Resaj/mando_rc/images/IMG-20140307-WA0002.jpg

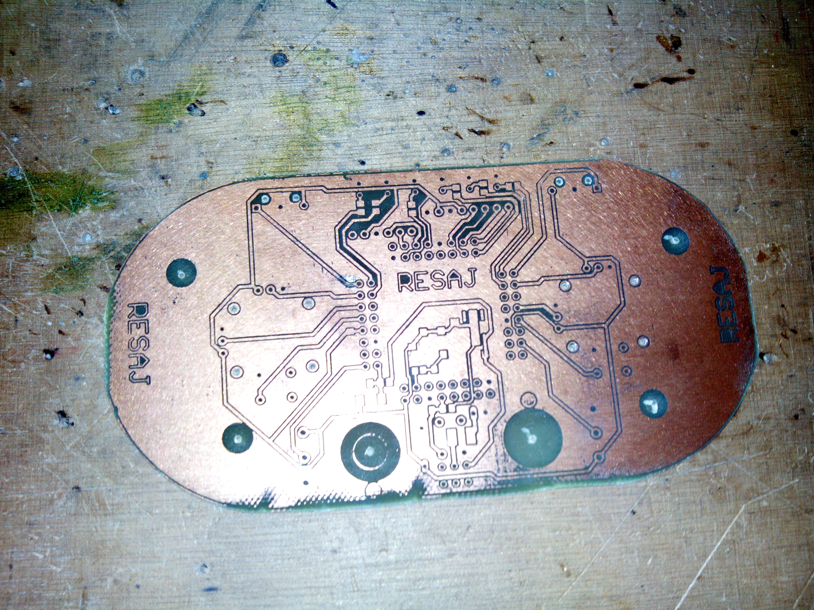
images/IMG-20140307-WA0002.jpg
