Resaj/mando_rc/images/IMG-20140309-WA0013.jpg

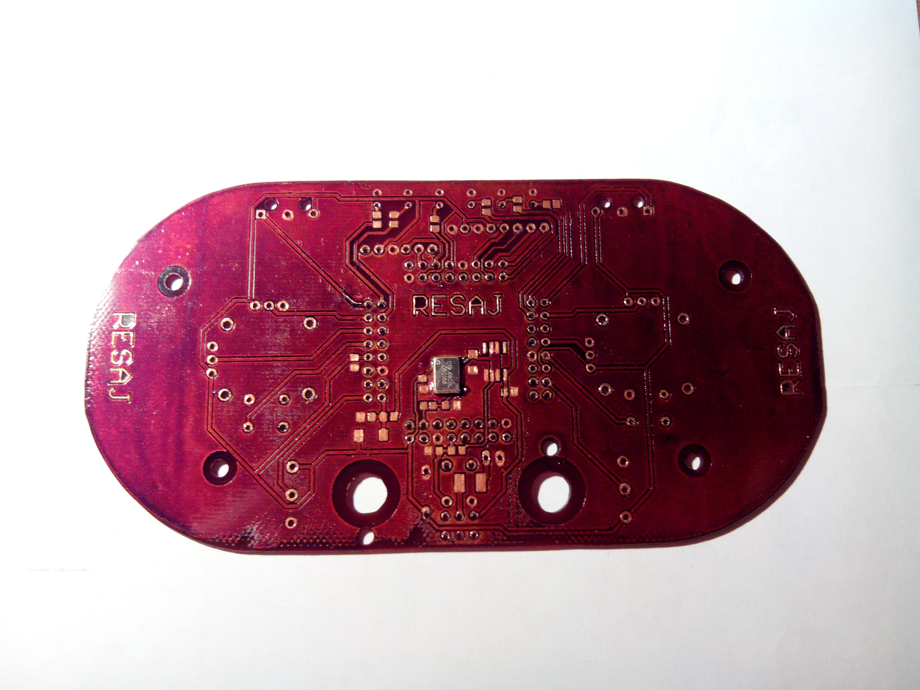
images/IMG-20140309-WA0013.jpg
