Resaj/mando_rc/images/IMG-20140312-WA0003.jpg

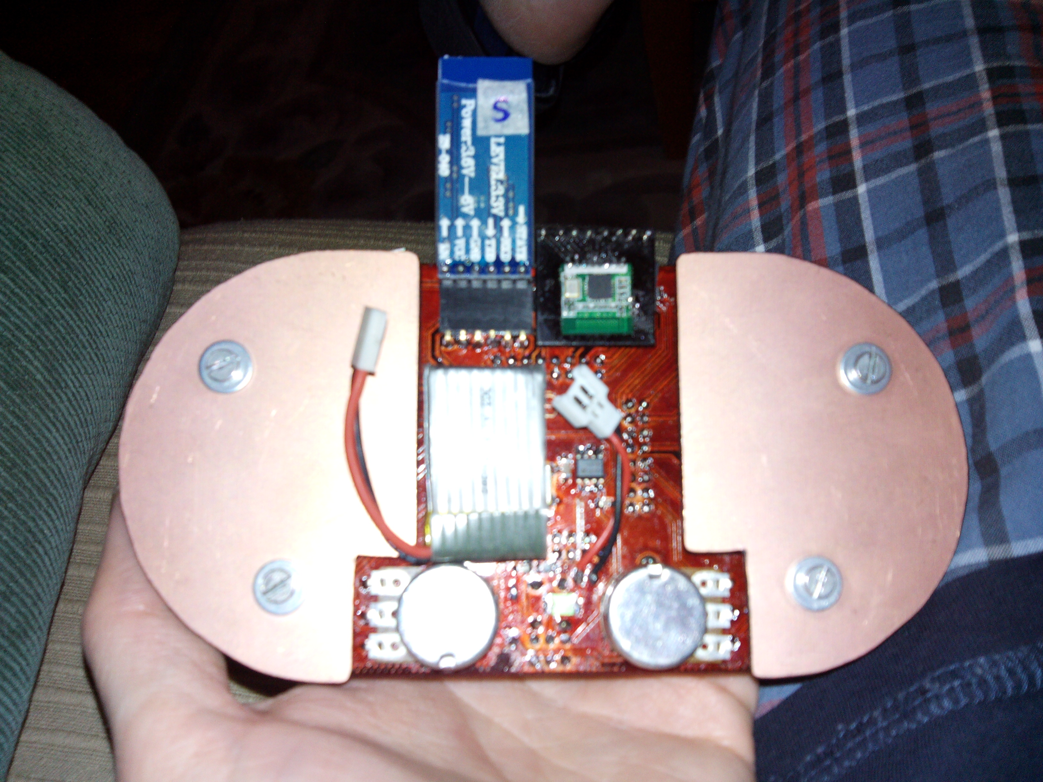
images/IMG-20140312-WA0003.jpg
