Resaj/mando_rc/images/IMG-20140319-WA0000.jpg

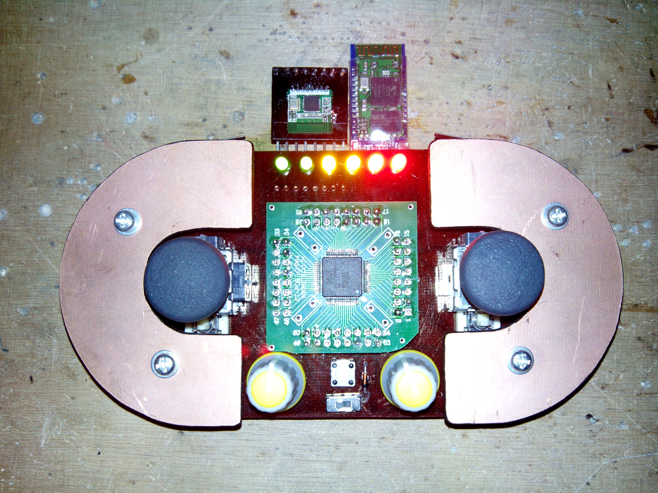
images/IMG-20140319-WA0000.jpg
