Resaj/mando_rc/images/IMG_20161116_005844.jpg

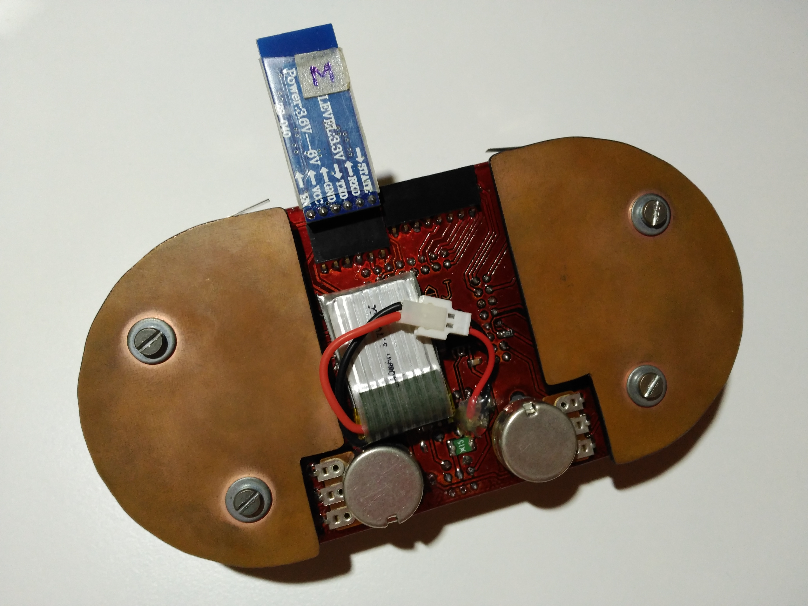
images/IMG_20161116_005844.jpg
