Resaj/mando_rc/eagle/Mando/Fotolitos/Adaptador RF2400nano.pdf

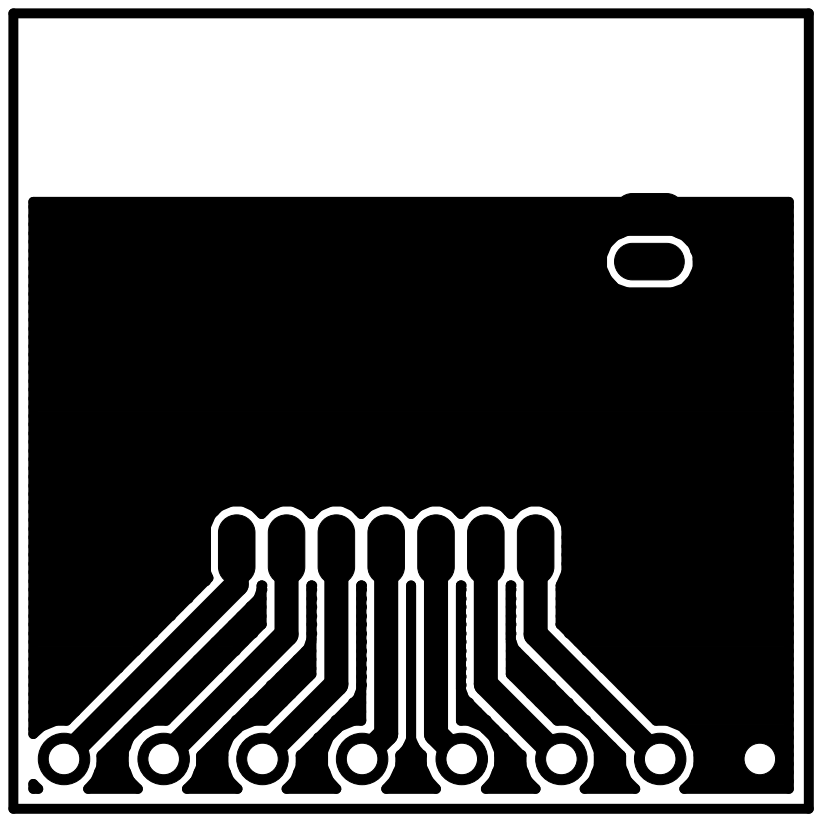
[picture p7: page 1]
