Resaj/mando_rc/eagle/Mando/Fotolitos/Mando.pdf

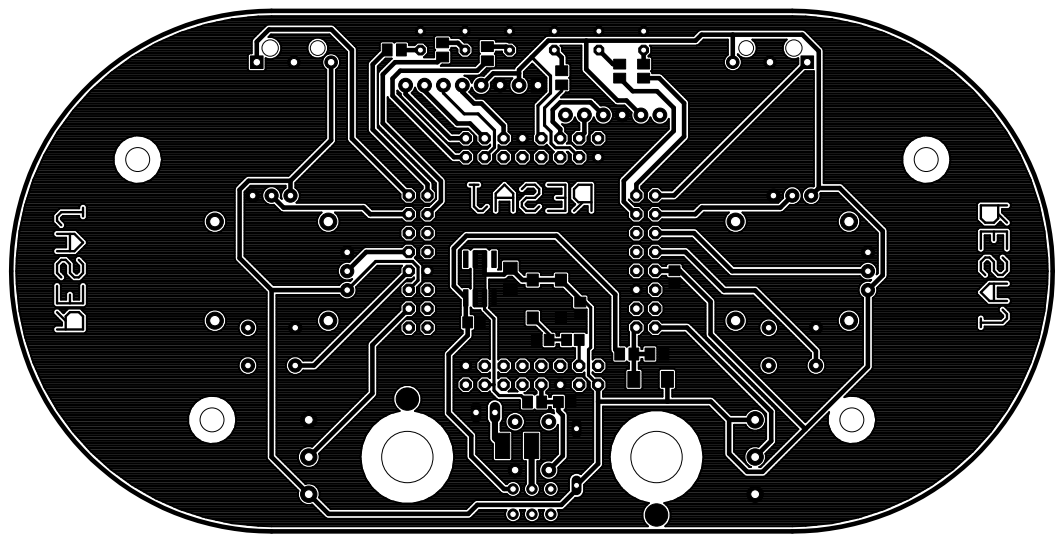
[picture p8: page 1]
