Resaj/mando_rc/eagle/Mando/Mando.brd

## EAGLE design eagle/Mando/Mando.brd (2016-11-15)

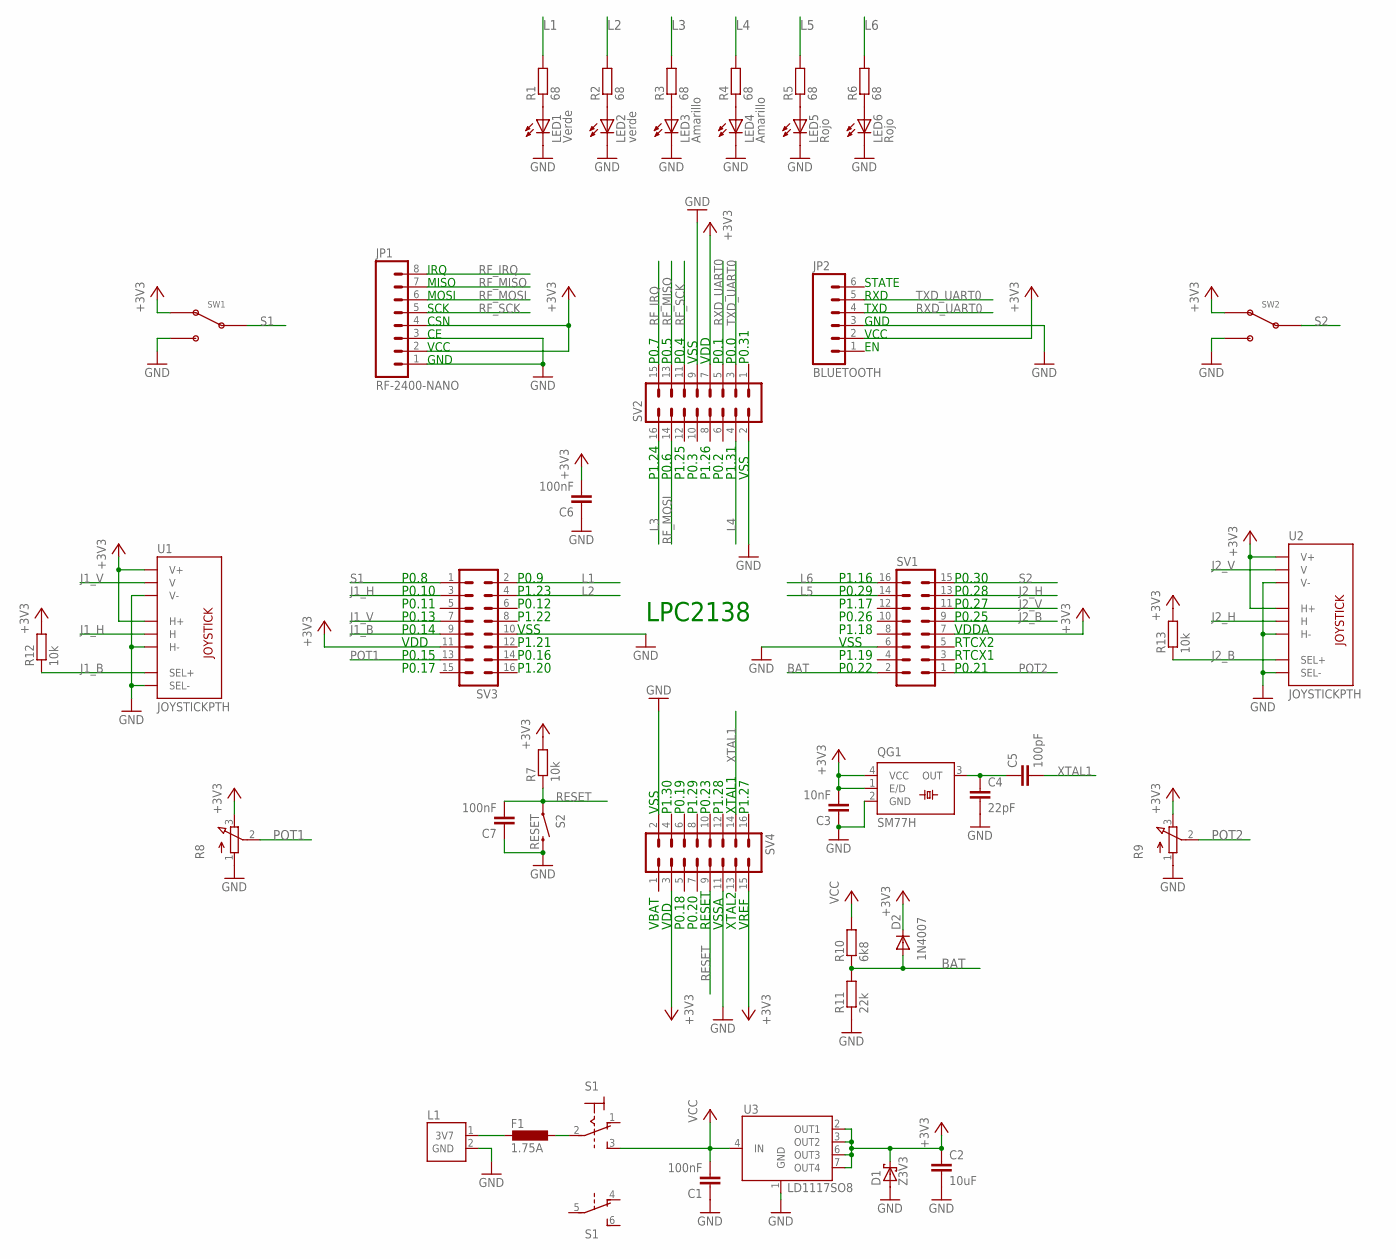
[picture p9: schematic Mando.sch]

Parts:
C1, C6, C7: 100nF; C0805
C2: 10uF; C1206
C3: 10nF; C0805
C4: 22pF; C0805
C5: 100pF; C0805
D1: Z3V3; DO35-7
D2: 1N4007; SOD106-R
F1: 1.75A; L1812
JP1: RF-2400-NANO; 1X08
JP2: BLUETOOTH; 1X06
L1: CONECTOR_LIPO_3.7V
LED1: Verde; LED3MM
LED2: verde; LED3MM
LED3, LED4: Amarillo; LED3MM
LED5, LED6: Rojo; LED3MM
QG1: SM77H
R1, R2, R3, R4, R5, R6: 68; M0805
R7, R12, R13: 10k; M0805
R8, R9: 3RP/1610N
R10: 6k8; M0805
R11: 22k; M0805
S1: SWITCH_2P2T_SL; SLIDE_SWITCH_2P2T
S2: RESET; TACTILE-PTH
SV1, SV2, SV3, SV4: MA08-2
SW1, SW2: SW_1382_R/A; SW_MX1382
U1, U2: JOYSTICKPTH; JOYSTICK
U3: LD1117SO8; SO8

Connections:
+3V3: C2.1, C3.2, C6.2, D1.C, D2.C, JP1.2, JP1.4, JP2.2, QG1.1 (E/D), QG1.4 (VCC), R7.2, R8.3 (E), R9.3 (E), R12.2, R13.2, SV1.7, SV2.7, SV3.11, SV4.3, SV4.15, SW1.N.C, SW2.N.C, U1.H1 (H+), U1.V1 (V+), U2.H1 (H+), U2.V1 (V+), U3.2 (OUT1), U3.3 (OUT2), U3.6 (OUT3), U3.7 (OUT4)
BAT: D2.A, R10.1, R11.2, SV1.2
GND: C1.1, C2.2, C3.1, C4.2, C6.1, C7.1, D1.A, JP1.1, JP1.3, JP2.3, L1.2 (GND), LED1.K (C), LED2.K (C), LED3.K (C), LED4.K (C), LED5.K (C), LED6.K (C), QG1.2 (GND), R8.1 (A), R9.1 (A), R11.1, S2.3 (2), SV1.6, SV2.2, SV2.9, SV3.10, SV4.2, SV4.11, SW1.N.O, SW2.N.O, U1.B2A (SEL-), U1.H3 (H-), U1.V3 (V-), U2.B2A (SEL-), U2.H3 (H-), U2.V3 (V-), U3.1 (GND)
J1_B: R12.1, SV3.9, U1.B1A (SEL+)
J1_H: SV3.3, U1.H2 (H)
J1_V: SV3.7, U1.V2 (V)
J2_B: R13.1, SV1.9, U2.B1A (SEL+)
J2_H: SV1.13, U2.H2 (H)
J2_V: SV1.11, U2.V2 (V)
L1: R1.2, SV3.2
L2: R2.2, SV3.4
L3: R3.2, SV2.16
L4: R4.2, SV2.4
L5: R5.2, SV1.14
L6: R6.2, SV1.16
unnamed: F1.2, L1.1 (3V7)
unnamed: F1.1, S1.2
unnamed: LED1.A, R1.1
unnamed: C4.1, C5.1, QG1.3 (OUT)
unnamed: LED2.A, R2.1
unnamed: LED3.A, R3.1
unnamed: LED4.A, R4.1
unnamed: LED5.A, R5.1
unnamed: LED6.A, R6.1
POT1: R8.2 (S), SV3.13
POT2: R9.2 (S), SV1.1
RESET: C7.2, R7.1, S2.1, SV4.9
RF_IRQ: JP1.8, SV2.15
RF_MISO: JP1.7, SV2.13
RF_MOSI: JP1.6, SV2.14
RF_SCK: JP1.5, SV2.11
RXD_UART0: JP2.4, SV2.5
S1: SV3.1, SW1.COM
S2: SV1.15, SW2.COM
TXD_UART0: JP2.5, SV2.3
VCC: C1.2, R10.2, S1.3 (S), U3.4 (IN)
XTAL1: C5.2, SV4.14

Notes on the sheet:
LPC2138
P0.21
P0.22
P0.25
P0.26
P0.27
P0.28
P0.29
P0.30
P0.31
P0.0
P1.31
P0.1
P0.2
P1.26
P0.3
P0.4
P0.5
P0.6
P0.7
P1.24
VBAT
VSS
VDD
P1.30
P0.18
P0.19
P0.20
P1.29
RESET
P0.23
VSSA
P1.28
XTAL2
XTAL1
VREF
P1.27
P1.20
P0.17
P0.8
P0.9
P0.10
P1.23
P0.11
P0.12
P0.13
P1.22
P0.14
P1.21
P0.15
P0.16
P1.25
RTCX1
RTCX2
VDDA
P1.18
P1.19
P1.17
P1.16
IRQ
MISO
MOSI
SCK
CSN
VCC
GND
STATE
RXD
TXD

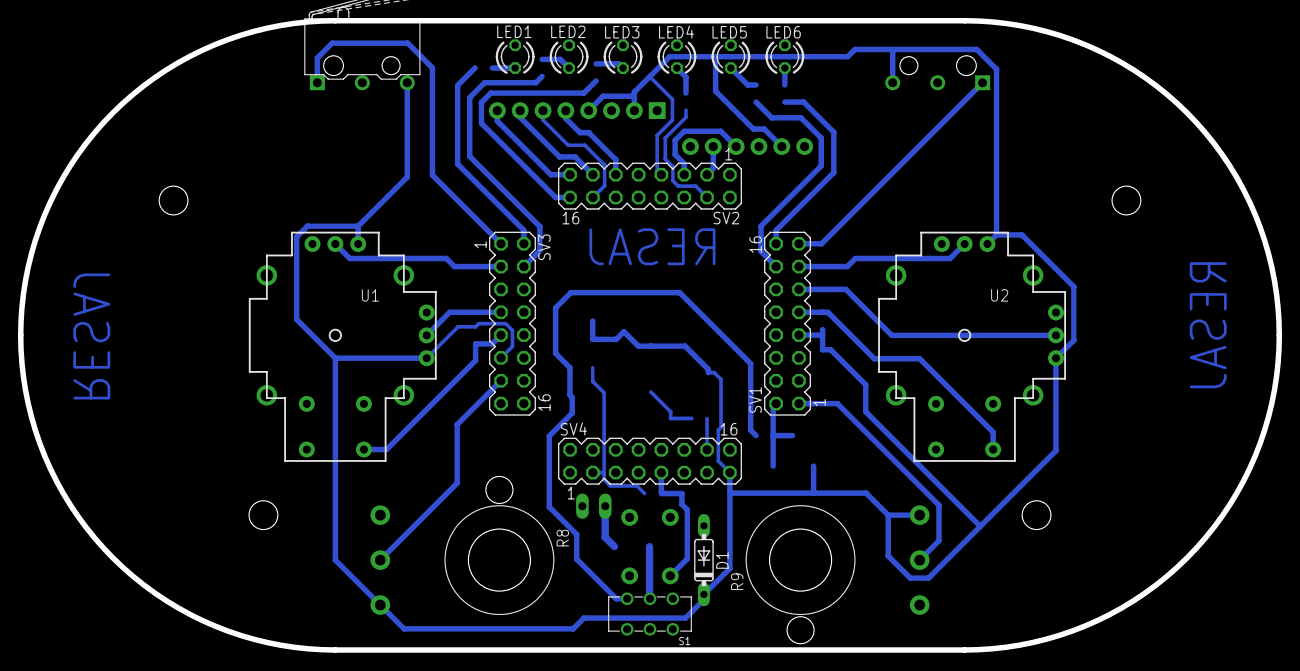
[picture p10: board Mando.brd from above]

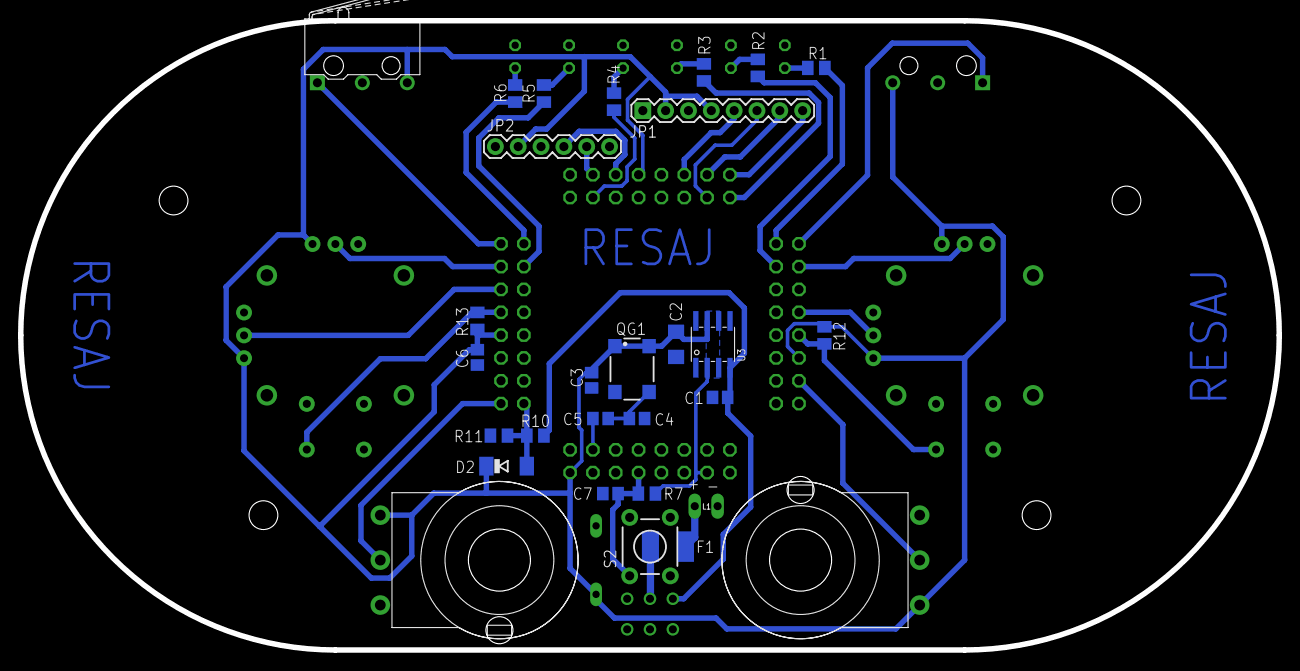
[picture p11: board Mando.brd from below]

Board: 2 copper layers, 140.0 x 70.0 mm, 44 parts (27 on the bottom side), 37 nets.
