Resaj/mando_rc/Programa mando sumo Cybertech 2012/LPClib.c

#ifndef LPCLIB_C
#define LPCLIB_C

#include <lpc213x.h>
#include "LPClib.h"
#include "target.h"


// Variables auxiliares para decodificar la señal del mando
unsigned long dato_mando = 0;			// Valor decodificado de la señal enviada por el mando
unsigned long captura_1, captura_2;		// Variables para tomar el número de cuentas en Capture0.0
int n_bit = 0;							// Variables auxiliares para tomar la señal del mando
char bit_start = '0', inicio_dato = '0';

// Variables auxiliares para el control de la UART0
char *uart0_buf_tx[N_MSG_UART0];
char uart0_rd = 0, uart0_wr = 0, uart0_repose = '1';
char uart0_msg = '0';
char uart0_cero = 0;
char *uart0_ptr_tx = &uart0_cero;


void ADC_CH_config(struct analog data_adc)
{
	struct data data_pin;
	data_pin.port = 0;

	if(data_adc.adc == ADC_0)
	{
		switch(data_adc.channel)
		{
			case ADC_CH0:
				data_pin.pin = 27;
				PINSEL_config(data_pin, ADC);
				break;
			case ADC_CH1:
				data_pin.pin = 28;
				PINSEL_config(data_pin, ADC);
				break;
			case ADC_CH2:
				data_pin.pin = 29;
				PINSEL_config(data_pin, ADC);
				break;
			case ADC_CH3:
				data_pin.pin = 30;
				PINSEL_config(data_pin, ADC);
				break;
			case ADC_CH4:
				data_pin.pin = 25;
				PINSEL_config(data_pin, ADC);
				break;
			case ADC_CH5:
				data_pin.pin = 26;
				PINSEL_config(data_pin, ADC);
				break;
			case ADC_CH6:
				data_pin.pin = 4;
				PINSEL_config(data_pin, ADC);
				break;
			case ADC_CH7:
				data_pin.pin = 5;
				PINSEL_config(data_pin, ADC);
		}
	}
	else if(data_adc.adc == ADC_1)
	{
		switch(data_adc.channel)
		{
			case ADC_CH0:
				data_pin.pin = 6;
				PINSEL_config(data_pin, ADC);
				break;
			case ADC_CH1:
				data_pin.pin = 8;
				PINSEL_config(data_pin, ADC);
				break;
			case ADC_CH2:
				data_pin.pin = 10;
				PINSEL_config(data_pin, ADC);
				break;
			case ADC_CH3:
				data_pin.pin = 12;
				PINSEL_config(data_pin, ADC);
				break;
			case ADC_CH4:
				data_pin.pin = 13;
				PINSEL_config(data_pin, ADC);
				break;
			case ADC_CH5:
				data_pin.pin = 15;
				PINSEL_config(data_pin, ADC);
				break;
			case ADC_CH6:
				data_pin.pin = 21;
				PINSEL_config(data_pin, ADC);
				break;
			case ADC_CH7:
				data_pin.pin = 22;
				PINSEL_config(data_pin, ADC);
		}
	}
}

void ADC_enable(int adc)
{
	if(adc == ADC_0)
		AD0CR = 0x200000;
	else if(adc == ADC_1)
		AD1CR = 0x200000;
}

unsigned int ADC_read(struct analog data_adc)
{
	unsigned int value = 0;

	if(data_adc.adc == ADC_0)
	{
		AD0CR |= (1<<24)|(1<<data_adc.channel);
		while ((AD0DR&(1<<31))==0);
		AD0CR &= ~((1<<24)|(1<<data_adc.channel));
		value = (AD0DR>>6)&0x03FF;
	}
	else if(data_adc.adc == ADC_1)
	{
		AD1CR |= (1<<24)|(1<<data_adc.channel);
		while ((AD1DR&(1<<31))==0);
		AD1CR &= ~((1<<24)|(1<<data_adc.channel));
		value = (AD1DR>>6)&0x03FF;
	}

	return value;
}

char BUTTON_status(struct data button_data_pin)
{
	char var = GPIO_read(button_data_pin);

	if(var == '0')
		return '1';
	else // var = '1'
		return '0';
}

void DAC_config(void)
{
	struct data pos = {0,25};
	PINSEL_config(pos, DAC);
}

void DAC_write(unsigned int value)
{
	int dac_register = DACR;

	if(value > 1023)
		value = 1023;

	dac_register &= ~(1023<<6);
	dac_register |= value<<6;
	DACR = dac_register;
}

unsigned int GP2Y0A_read(struct analog data_adc)
{
	unsigned int adc_value, distance_value;

	adc_value = ADC_read(data_adc);

	if(adc_value > 23)
		distance_value = 25*((3000.0 / (adc_value - 23) + 0.3)); // Fórmula de conversión de tensión a mm.
	else
		distance_value = 800;

	if (distance_value > 800)
		distance_value = 800;
	else if (distance_value < 100)
		distance_value = 100;

	return distance_value;
}

unsigned int GP2D120_read(struct analog data_adc)
{
	unsigned int adc_value, distance_value;

	adc_value = ADC_read(data_adc);

	distance_value = 16.8*((2914.0 / (adc_value + 35) - 0.5)); // Fórmula de conversión de tensión a mm.

	if (distance_value > 350)
		distance_value = 350;
	else if (distance_value < 40)
		distance_value = 40;

	return distance_value;
}

char DISTANCE_digital_read(struct data sensor_data_pin)
{
	char var = GPIO_read(sensor_data_pin);

	if(var == '0')
		return '1';
	else // var = '1'
		return '0';
}

void EINT_config(struct data data_pin, char mode, char polar, unsigned int priority)
{
	int ext_int;
	unsigned int int_num;
	unsigned long name;

	if(data_pin.port == 0)
	{
		switch(data_pin.pin)
		{
			case 1:
				ext_int = 0;
				break;
			case 3:
				ext_int = 1;
				break;
			case 7:
				ext_int = 2;
				break;
			case 9:
				ext_int = 3;
				break;
			case 14:
				ext_int = 1;
				break;
			case 15:
				ext_int = 2;
				break;
			case 16:
				ext_int = 2;
				break;
			case 20:
				ext_int = 3;
				break;
			case 30:
				ext_int = 3;
		}
	}

	switch(ext_int)
	{
		case 0:
			int_num = 14;
			name = (unsigned long) EINT_0;
			break;
		case 1:
			int_num = 15;
			name = (unsigned long) EINT_1;
			break;
		case 2:
			int_num = 16;
			name = (unsigned long) EINT_2;
			break;
		default: // ext_int = 3
			int_num = 17;
			name = (unsigned long) EINT_3;
	}

	if(mode == LEVEL)
		EXTMODE &= ~(1<<ext_int);
	else // mode = EDGE
		EXTMODE |= 1<<ext_int;

	if(polar == DOWN)
		EXTPOLAR &= ~(1<<ext_int);
	else // polar = UP
		EXTPOLAR |= 1<<ext_int;

	PINSEL_config(data_pin, EINT);
	VIC_assign(name, priority, int_num);
}

float ENCODER_distance(float diameter, int edge_num, int cont)
{
	float distance;
	distance = pi * diameter * cont / edge_num;

	return distance;
}

float ENCODER_speed(float diameter, int edge_num, float time)
{
	float speed;

	speed = pi * diameter / (1000 * edge_num * time);

	return speed;
}

void GPIO_config(struct data data_pin, char inout)
{
	if(inout == IN)
	{
		if(data_pin.port == 0)
			IO0DIR &= ~(1<<data_pin.pin);
		else // port = 1
			IO1DIR &= ~(1<<data_pin.pin);
	}
	else // inout = OUT
	{
		if(data_pin.port == 0)
			IO0DIR |= 1<<data_pin.pin;
		else // port = 1
			IO1DIR |= 1<<data_pin.pin;
	}
}

void GPIO_set(struct data data_pin, unsigned char status)
{
	if(status == PIN_OFF)
	{
		if(data_pin.port == 0)
			IOCLR0 = 1<<data_pin.pin;
		else // port = 1
			IOCLR1 = 1<<data_pin.pin;
	}
	else // status = PIN_ON
	{
		if(data_pin.port == 0)
			IOSET0 = 1<<data_pin.pin;
		else // port = 1
			IOSET1 = 1<<data_pin.pin;
	}		
}

char GPIO_read(struct data data_pin)
{
	if(data_pin.port == 0)
	{
		if((IO0PIN&(1<<data_pin.pin)) == 0)
			return '0';
		else
			return '1';
	}
	else // port = 1
	{
		if((IO1PIN&(1<<data_pin.pin)) == 0)
			return '0';
		else
			return '1';
	}
}

void LED_set(struct data led_data_pin, unsigned char status)
{
	GPIO_set(led_data_pin, status);
}

unsigned int LINE_SENSOR_read(struct analog data_adc)
{
	unsigned int value;
	value = ADC_read(data_adc);
	return value;
}

char LIPO_TENSION_read(struct analog data_adc, float v_min)
{
	unsigned int value;
	value = ADC_read(data_adc);

	if(value < v_min*1023/3.28)
		return '1';
	else
		return '0';
}

void MOTOR_config(struct motor MOTOR)
{
	GPIO_config(MOTOR.bridge_h_pos_data_pin, OUT);
	GPIO_config(MOTOR.bridge_h_neg_data_pin, OUT);

	PWM_CH_config(MOTOR.channel);
}

void MOTOR_SPEED_set(struct motor MOTOR, float speed, char mode)
{
	if(mode == FORWARD)
	{
		GPIO_set(MOTOR.bridge_h_pos_data_pin, PIN_ON);
		GPIO_set(MOTOR.bridge_h_neg_data_pin, PIN_OFF);
	}
	else if(mode == BACKWARD)
	{
		GPIO_set(MOTOR.bridge_h_pos_data_pin, PIN_OFF);
		GPIO_set(MOTOR.bridge_h_neg_data_pin, PIN_ON);
	}
	else if(mode == LOCKED)
	{
		GPIO_set(MOTOR.bridge_h_pos_data_pin, PIN_ON);
		GPIO_set(MOTOR.bridge_h_neg_data_pin, PIN_ON);
	}
	else // mode == FREE
	{
		GPIO_set(MOTOR.bridge_h_pos_data_pin, PIN_OFF);
		GPIO_set(MOTOR.bridge_h_neg_data_pin, PIN_OFF);
	}

	PWM_set(MOTOR.channel, speed);
}

void PINSEL_config(struct data data_pin, char mode)
{
	if(data_pin.port == 0)
	{
		switch(data_pin.pin)
		{
			case 0:
				switch(mode)
				{
					case UART:
						PINSEL0 |= 1<<0;
						break;
					case PWM:
						PINSEL0 |= 2<<0;
				}
				break;
			case 1:
				switch(mode)
				{
					case UART:
						PINSEL0 |= 1<<2;
						break;
					case PWM:
						PINSEL0 |= 2<<2;
						break;
					case EINT:
						PINSEL0 |= 3<<2;
				}
				break;
			case 2:
				switch(mode)
				{
					case I2C:
						PINSEL0 |= 1<<4;
						break;
					case CAPTURE:
						PINSEL0 |= 2<<4;
				}
				break;
			case 3:
				switch(mode)
				{
					case I2C:
						PINSEL0 |= 1<<6;
						break;
					case MATCH:
						PINSEL0 |= 2<<6;
						break;
					case EINT:
						PINSEL0 |= 3<<6;
				}
				break;
			case 4:
				switch(mode)
				{
					case SPI:
						PINSEL0 |= 1<<8;
						break;
					case CAPTURE:
						PINSEL0 |= 2<<8;
						break;
					case ADC:
						PINSEL0 |= 3<<8;
				}
				break;
			case 5:
				switch(mode)
				{
					case SPI:
						PINSEL0 |= 1<<10;
						break;
					case MATCH:
						PINSEL0 |= 2<<10;
						break;
					case ADC:
						PINSEL0 |= 3<<10;
				}
				break;
			case 6:
				switch(mode)
				{
					case SPI:
						PINSEL0 |= 1<<12;
						break;
					case CAPTURE:
						PINSEL0 |= 2<<12;
						break;
					case ADC:
						PINSEL0 |= 3<<12;
				}
				break;
			case 7:
				switch(mode)
				{
					case SPI:
						PINSEL0 |= 1<<14;
						break;
					case PWM:
						PINSEL0 |= 2<<14;
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
				}
				break;
			case 30:
				switch(mode)
				{
					case ADC:
						PINSEL1 |= 1<<28;
						break;
					case EINT:
						PINSEL1 |= 2<<28;
						break;
					case CAPTURE:
						PINSEL1 |= 3<<28;
				}
				break;
		}
	}
}

void PWM_CH_config(int channel)
{
	struct data data_pin;

	if(channel == PWM1)
	{
		data_pin.port = 0;
		data_pin.pin = 0;
		PINSEL_config(data_pin, PWM);
		PWMLER |= 1<<1;
		PWMPCR |= 1<<9;
	}
	else if(channel == PWM2)
	{
		data_pin.port = 0;
		data_pin.pin = 7;
		PINSEL_config(data_pin, PWM);
		PWMLER |= 1<<2;
		PWMPCR |= 1<<10;
	}
	else if(channel == PWM3)
	{
		data_pin.port = 0;
		data_pin.pin = 1;
		PINSEL_config(data_pin, PWM);
		PWMLER |= 1<<3;
		PWMPCR |= 1<<11;
	}
	else if(channel == PWM4)
	{
		data_pin.port = 0;
		data_pin.pin = 8;
		PINSEL_config(data_pin, PWM);
		PWMLER |= 1<<4;
		PWMPCR |= 1<<12;
	}
	else if(channel == PWM5)
	{
		data_pin.port = 0;
		data_pin.pin = 21;
		PINSEL_config(data_pin, PWM);
		PWMLER |= 1<<5;
		PWMPCR |= 1<<13;
	}
	else if(channel == PWM6)
	{
		data_pin.port = 0;
		data_pin.pin = 9;
		PINSEL_config(data_pin, PWM);
		PWMLER |= 1<<6;
		PWMPCR |= 1<<14;
	}
}

void PWM_enable(float period)
{
	PWMTCR = 0x02;				// Reset TIMER y PREESCALER										   
	PWMPR = 0;					// El PRESCALER no modifica la frecuencia
	PWM_set(0, 100);			// Fijar periodo de PWM
	PWMMCR = 0x02;				// Reset TIMER COUNTER REGISTER ON MATCH0							   
	PWMTCR = (1<<0)|(1<<3);		// Habilitar PWM y comenzar la cuenta
}

void PWM_set(int channel, float value)
{
	if(channel == 0)
		PWMMR0 = (float) value * Fpclk * PWM_PERIOD / 100;
	else if(channel == 1)
		PWMMR1 = (float) value * Fpclk * PWM_PERIOD / 100;
	else if(channel == 2)
		PWMMR2 = (float) value * Fpclk * PWM_PERIOD / 100;
	else if(channel == 3)
		PWMMR3 = (float) value * Fpclk * PWM_PERIOD / 100;
	else if(channel == 4)
		PWMMR4 = (float) value * Fpclk * PWM_PERIOD / 100;
	else if(channel == 5)
		PWMMR5 = (float) value * Fpclk * PWM_PERIOD / 100;
	else if(channel == 6)
		PWMMR6 = (float) value * Fpclk * PWM_PERIOD / 100;

	PWMLER |= 1<<channel;
}

void SERVO_config(int channel)
{
	PWM_CH_config(channel);
}

void SERVO_set (int channel, float position)
{
	if (position > 100)
		position = 100;
	else if(position < 0)
		position = 0;

	position = SERVO_MIN_POS + (position * (SERVO_MAX_POS - SERVO_MIN_POS)) / 100; 
	PWM_set(channel, position);
}

void remote_IR(char channel)
{
	double F = Fpclk;

	captura_2 = CAPTURE_get_timer(channel);

	// Si la diferencia de cuentas entre los instantes 1 y 2 es de 3ms: bit de start
	if((((captura_2-captura_1)/F) > 2.8e-3) && ((((captura_2)-(captura_1))/F) < 3.2e-3))
	{
		bit_start = '1';	// LLega el bit de start y comienza la secuencia
		n_bit = -1;		// Bit de start con peso -1
		dato_mando = 0;	// Se inicia el dato a 0
	}
	// Si la diferencia de cuentas entre los instantes 1 y 2 es de 1.8ms: bit del dato a 1
	if(bit_start == '1' && (((captura_2-captura_1)/F > 1.6e-3) && (captura_2-captura_1)/F < 2.0e-3))
		dato_mando += 2^n_bit;	// Sumar bit decodificado al dato
	n_bit++;	// Aumentar el peso para el siguiente bit
	
	if(!captura_1)
		inicio_dato = '1';		// Primer flanco 	
	if(n_bit == 11)		// Si ha llegado el último bit del dato
		CAPTURE_CHANNEL_edge_set(channel, RISING_EDGE);
	else if(n_bit == 12)
	{
		// Si la diferencia de cuentas entre los instantes 1 y 2 es de 1.2ms: bit de stop
		if(bit_start == '1' && (((captura_2-captura_1)/F > 1.0e-3) && (captura_2-captura_1)/F < 1.4e-3))
			dato_mando += 2048;		//Captura último dato
		bit_start = '0';		// Borrar variables
		inicio_dato = '0';
		captura_1 = 0;
													
		CAPTURE_CHANNEL_edge_set(channel, FALLING_EDGE);
	}			
	if(inicio_dato == '1')	// Si la toma del dato está en proceso:
		captura_1 = CAPTURE_get_timer(channel);
}

void MATCH_CHANNEL_config(char channel, float period)
{
	switch(channel)
	{
		case MATCH0_0:
			T0MCR |= 3<<0;
			T0MR0 = (unsigned long)(period*Fpclk);			
			break;
		case MATCH0_1:
			T0MCR |= 3<<3;
			T0MR1 = (unsigned long)(period*Fpclk);			
			break;
		case MATCH0_2:
			T0MCR |= 3<<6;
			T0MR2 = (unsigned long)(period*Fpclk);			
			break;
		case MATCH0_3:
			T0MCR |= 3<<9;
			T0MR3 = (unsigned long)(period*Fpclk);
			break;			
		case MATCH1_0:
			T1MCR |= 3<<0;
			T1MR0 = (unsigned long)(period*Fpclk);			
			break;
		case MATCH1_1:
			T1MCR |= 3<<3;
			T1MR1 = (unsigned long)(period*Fpclk);			
			break;
		case MATCH1_2:
			T1MCR |= 3<<6;
			T1MR2 = (unsigned long)(period*Fpclk);			
			break;
		case MATCH1_3:
			T1MCR |= 3<<9;
			T1MR3 = (unsigned long)(period*Fpclk);
	}
}

void CAPTURE_CHANNEL_config(char channel, struct data data_pin, char edge)
{
	PINSEL_config(data_pin, CAPTURE);

	CAPTURE_CHANNEL_edge_set(channel, edge);
}

void CAPTURE_CHANNEL_edge_set(char channel, char edge)
{
	switch(channel)
	{
		case CAPTURE0_0:
			T0CCR |= (4+edge)<<0;
			break;
		case CAPTURE0_1:
			T0CCR |= (4+edge)<<3;
			break;
		case CAPTURE0_2:
			T0CCR |= (4+edge)<<6;
			break;
		case CAPTURE0_3:
			T0CCR |= (4+edge)<<9;
			break;			
		case CAPTURE1_0:
			T1CCR |= (4+edge)<<0;
			break;
		case CAPTURE1_1:
			T1CCR |= (4+edge)<<3;
			break;
		case CAPTURE1_2:
			T1CCR |= (4+edge)<<6;
			break;
		case CAPTURE1_3:
			T1CCR |= (4+edge)<<9;
	}
}

unsigned long CAPTURE_get_timer(char channel)
{
	unsigned long timer;

	if(channel == CAPTURE0_0)
  		timer = T0CR0;
	else if(channel == CAPTURE0_1)
  		timer = T0CR1;
	else if(channel == CAPTURE0_2)
  		timer = T0CR2;
	else if(channel == CAPTURE0_3)
  		timer = T0CR3;
	else if(channel == CAPTURE1_0)
  		timer = T1CR0;
	else if(channel == CAPTURE1_1)
  		timer = T1CR1;
	else if(channel == CAPTURE1_2)
  		timer = T1CR2;
	else if(channel == CAPTURE1_3)
  		timer = T1CR3;

	return timer;
}

void TIMER_config(char timer, char mode, unsigned int priority)
{
	int int_num;
	unsigned long name;

	if(mode == MATCH_MODE)
	{
		if(timer == TIMER0)
		{
			int_num = 4;
			name = (unsigned long) TIMER_0;

			T0TCR = 0x02;
			T0PR = 0;
			T0TCR = 0x01;
		}
		else // timer = TIMER1
		{
			int_num = 5;
			name = (unsigned long) TIMER_1;

			T1TCR = 0x02;
			T1PR = 0; 	
			T1TCR = 0x01;
		}
	}
	else // mode = CAPTURE_MODE
	{
		if(timer == TIMER0)
		{
			int_num = 4;
			name = (unsigned long) TIMER_0;

			T0TCR = 0x02;
			T0CTCR = 0;
			T0PR = 0;
			T0TCR = 0x01;
		}
		else // timer = TIMER1
		{
			int_num = 5;
			name = (unsigned long) TIMER_1;

			T1TCR = 0x02;
			T1CTCR = 0;
			T1PR = 0;
			T1TCR = 0x01;
		}
	}
	
	VIC_assign(name, priority, int_num);
}

void UART0_config(unsigned int baudrate, unsigned int priority)
{
	int Fdiv = 0;
	int int_num;
	unsigned long name;
	struct data data_pin;

	int_num = 6;
	name = (unsigned long) UART0;

	data_pin.port = 0;
	data_pin.pin = 0;
	PINSEL_config(data_pin, UART);
	data_pin.pin = 1;
	PINSEL_config(data_pin, UART);

	U0FCR = 0x00;				// Deshabilitar FIFO's
	U0LCR = 0x83;				// 8 bits, sin bit de paridad y 1 bit de stop

    Fdiv = (Fpclk / 16) / baudrate;
    U0DLM = Fdiv / 256;							
    U0DLL = Fdiv % 256;	   

	U0LCR = 0x3;				// DLAB = 0
	U0IER = 0x03;				// Activar recepción y transmisión de datos

	U0THR = 0;

	VIC_assign(name, priority, int_num);
}

void UART0_send(char *msg)
{
	uart0_buf_tx[uart0_wr] = msg;	// Se añade al buffer de transmisión el puntero al mensaje
	uart0_wr++; 					// Se gestiona el puntero de escritura de forma circular
	uart0_wr &= N_MSG_UART0-1;		// Para mantener el modulo de cuenta
	uart0_msg = '1';
	if (uart0_repose == '1')	// No quedaban caracteres pendientes de enviar
	{
		uart0_repose = '0';
		U0THR = 0;
	}
}

void VIC_assign(unsigned long name, unsigned int priority, unsigned int num)
{
	switch(priority)
	{
		case 0:
			VICVectAddr0 = name;
			VICVectCntl0 = (0x20|num);
			break;
		case 1:
			VICVectAddr1 = name;
			VICVectCntl1 = (0x20|num);
			break;
		case 2:
			VICVectAddr2 = name;
			VICVectCntl2 = (0x20|num);
			break;
		case 3:
			VICVectAddr3 = name;
			VICVectCntl3 = (0x20|num);
			break;
		case 4:
			VICVectAddr4 = name;
			VICVectCntl4 = (0x20|num);
			break;
		case 5:
			VICVectAddr5 = name;
			VICVectCntl5 = (0x20|num);
			break;
		case 6:
			VICVectAddr6 = name;
			VICVectCntl6 = (0x20|num);
			break;
		case 7:
			VICVectAddr7 = name;
			VICVectCntl7 = (0x20|num);
			break;
		case 8:
			VICVectAddr8 = name;
			VICVectCntl8 = (0x20|num);
			break;
		case 9:
			VICVectAddr9 = name;
			VICVectCntl9 = (0x20|num);
			break;
		case 10:
			VICVectAddr10 = name;
			VICVectCntl10 = (0x20|num);
			break;
		case 11:
			VICVectAddr11 = name;
			VICVectCntl11 = (0x20|num);
			break;
		case 12:
			VICVectAddr12 = name;
			VICVectCntl12 = (0x20|num);
			break;
		case 13:
			VICVectAddr13 = name;
			VICVectCntl13 = (0x20|num);
			break;
		case 14:
			VICVectAddr14 = name;
			VICVectCntl14 = (0x20|num);
			break;
		default: // priority = 15
			VICVectAddr15 = name;
			VICVectCntl15 = (0x20|num);
	}

	VICIntEnable |= 1<<num;
}


#endif
