Resaj/mando_rc/Programa mando sumo Cybertech 2012/target.h

#ifndef TARGET_H
#define TARGET_H

#define Fpclk 		19.6608e6*3/4	// Frecuencia del cristal del LPC2138
#define PWM_PERIOD	1e-5			// Periodo de PWM
#define BAT_PERIOD	2				// Periodo de ejecución de la interrupción periódica de la batería
#define PER_PERIOD	50e-3			// Periodo de ejecución de la interrupción periódica principal

#endif
